Mahmoud-elzeftawy/Cosmic-Wars/poster.jpg

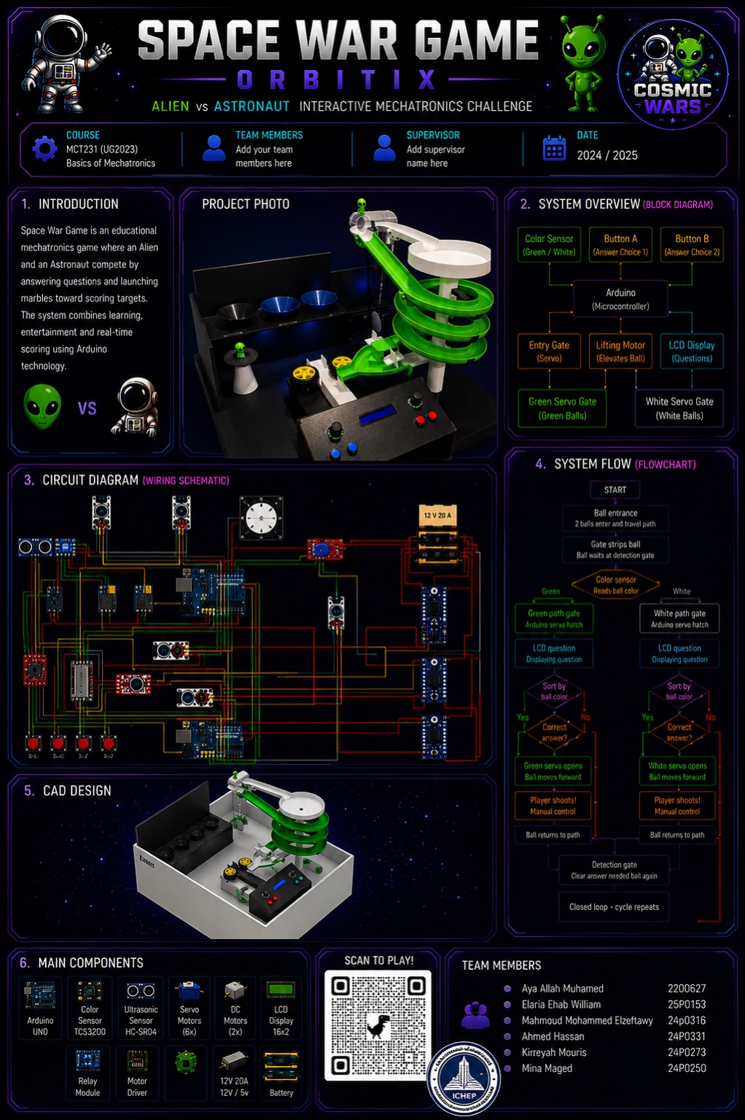
poster.jpg
